andyrew/coin-relay/photos/IMG_5291.jpg

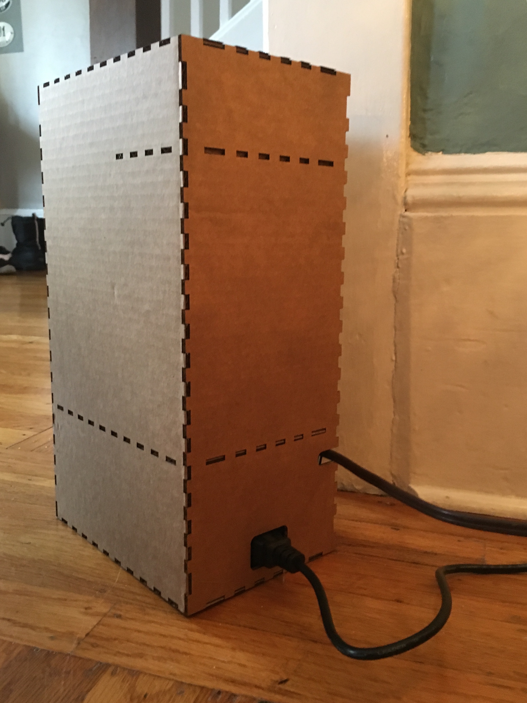
photos/IMG_5291.jpg
